BrandonVP/SwitchWarden/teensy40_480x320_lcd.pdf

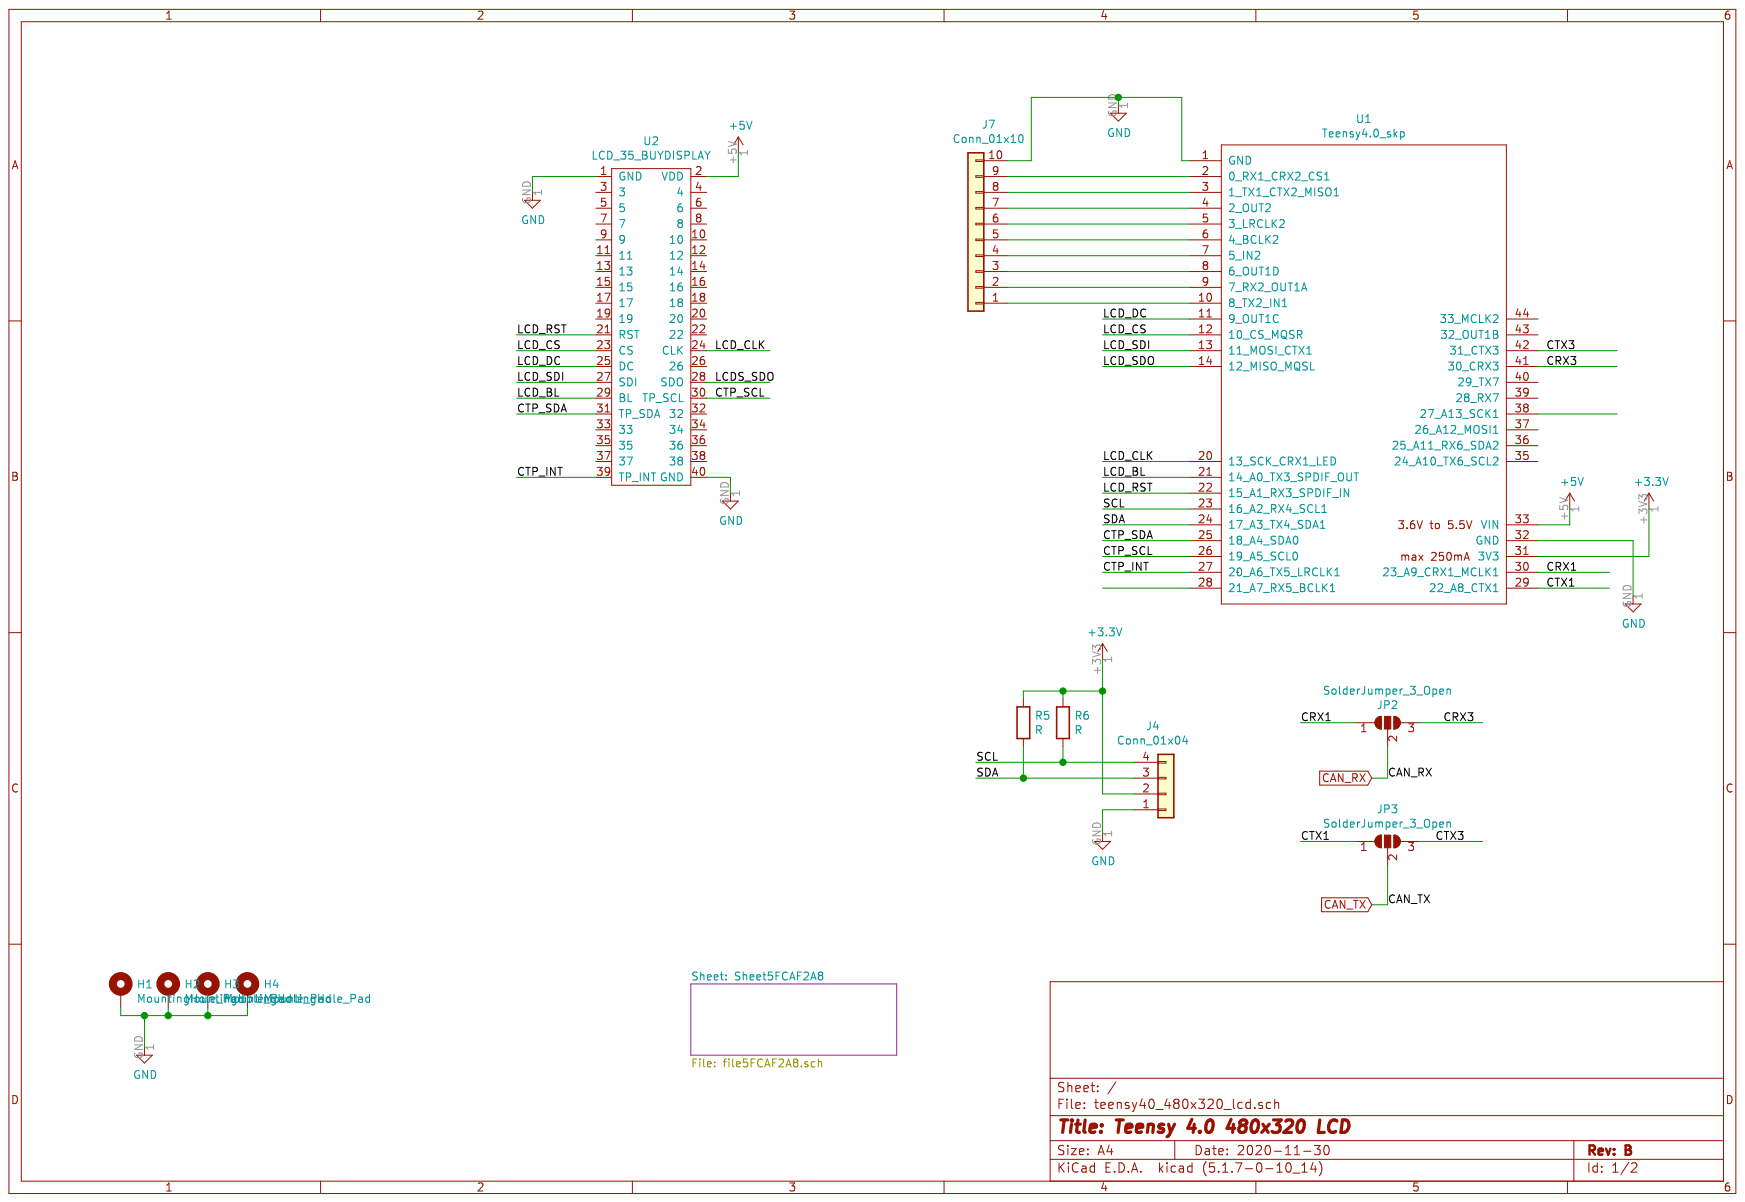
[picture p1: page 1]

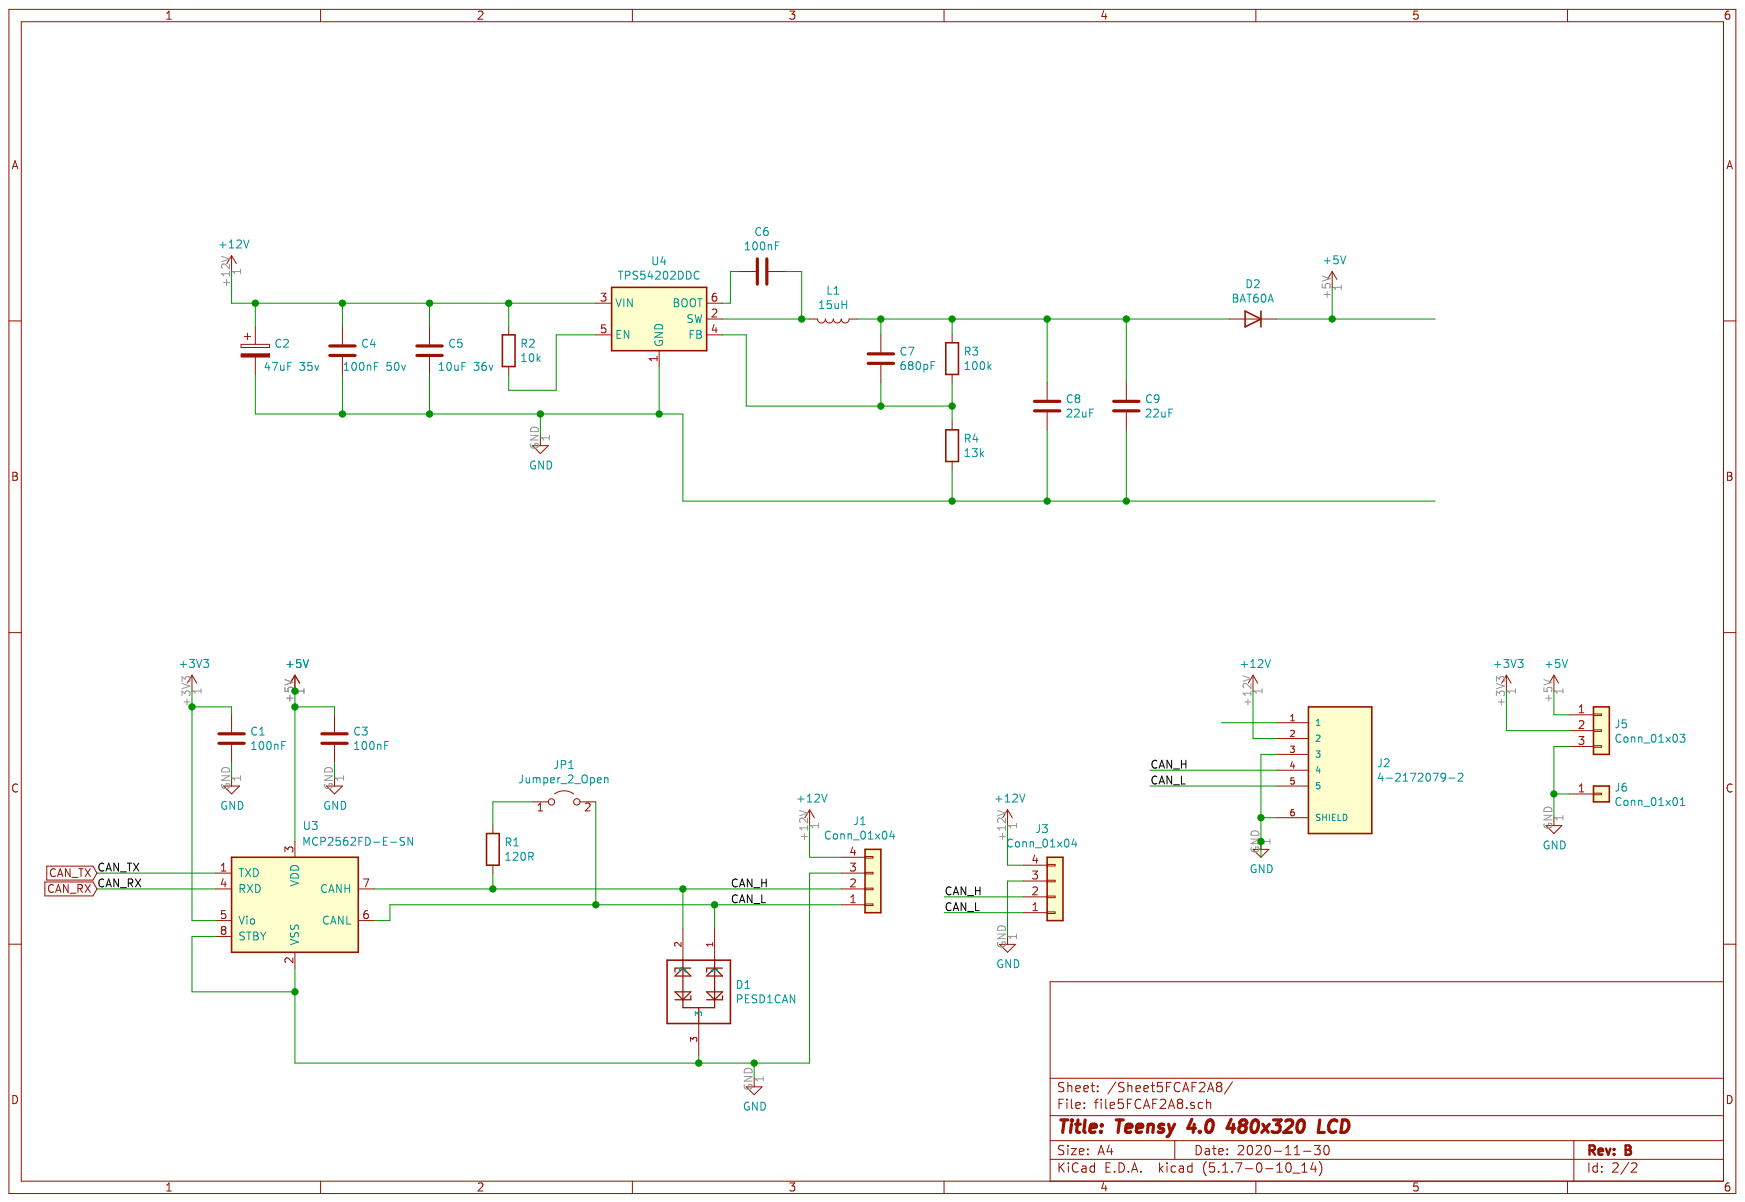
[picture p2: page 2]
