BrandonVP/SwitchWarden/SwitchWarden/PowerApp.cpp

/*
===========================================================================
Name        : PowerApp.cpp
Author      : Brandon Van Pelt
Description : Power tab UI (see PowerApp.h). Three buttons per PSU row: a name
              label, a live run-status pill, and a start/stop action button.
===========================================================================
*/
#include "PowerApp.h"
#include "PowerControl.h"

// Three buttons per PSU row.
static uint8_t nameIdx(uint8_t p)   { return (uint8_t)(3 * p + 0); }
static uint8_t statusIdx(uint8_t p) { return (uint8_t)(3 * p + 1); }
static uint8_t actionIdx(uint8_t p) { return (uint8_t)(3 * p + 2); }

// Action button click-return values (1..PSU_COUNT; -1 means "no tap").
static const int ACTION_BASE = 1;

// Fixed accent colors (RGB565) that read the same across themes.
static const uint16_t COL_RUN   = 0x07E0; // green — running
static const uint16_t COL_LOCK  = 0x8410; // grey  — cooling locked on
static const uint16_t COL_DIM   = 0x8410; // grey  — "OFF" / disabled text
static const uint16_t COL_FAULT = 0xF800; // red   — cooling-loss safety fault

static const char* const PSU_NAMES[PSU_COUNT] = { "Brandon", "Jason", "Ubuntu", "Cooling" };

static bool s_lastRunning[PSU_COUNT];
static bool s_lastCommanded[PSU_COUNT];

static void styleStatus(uint8_t p)
{
    UserInterfaceClass& s = GUI_I.appButtons()[statusIdx(p)];

    // Cooling-loss fault takes over the cooling row's pill.
    if (p == PSU_COOLING && POWER_isCoolingFault())
    {
        s.setText("FAULT");
        s.setBgColor(COL_FAULT);
        s.setBorderColor(COL_FAULT);
        s.setTextColor(0xFFFF);
        return;
    }

    bool run = POWER_isRunning(p);
    s.setText(run ? "RUNNING" : "OFF");
    s.setBgColor(run ? COL_RUN : gfxTheme.background);
    s.setBorderColor(run ? COL_RUN : gfxTheme.btnBorder);
    s.setTextColor(run ? 0x0000 : COL_DIM);
}

static void styleAction(uint8_t p)
{
    UserInterfaceClass& a = GUI_I.appButtons()[actionIdx(p)];

    // While a cooling fault is latched, the cooling action becomes "ACK".
    if (p == PSU_COOLING && POWER_isCoolingFault())
    {
        a.setText("ACK");
        a.setBgColor(COL_FAULT);
        a.setBorderColor(COL_FAULT);
        a.setTextColor(0xFFFF);
        a.setClickable(true);
        return;
    }

    bool on = POWER_isCommanded(p);
    bool locked = (p == PSU_COOLING) && POWER_isCoolingLocked();

    if (locked)
    {
        a.setText("LOCKED");
        a.setBgColor(gfxTheme.orangeBtn);
        a.setBorderColor(COL_LOCK);
        a.setTextColor(0x0000);
        a.setClickable(false);
    }
    else
    {
        a.setText(on ? "STOP" : "START");
        a.setBgColor(on ? gfxTheme.orangeBtn : gfxTheme.btnColor);
        a.setBorderColor(gfxTheme.btnBorder);
        a.setTextColor(on ? 0x0000 : gfxTheme.btnText);
        a.setClickable(true);
    }
}

uint8_t power_createBtns(void)
{
    UserInterfaceClass* b = GUI_I.appButtons();

    // Airy backdrop: a light-blue -> white gradient behind the cards.
    GUI_I.fillGradientV(0, GFX_MENU_BAR_HEIGHT, GFX_SCREEN_WIDTH, GFX_SCREEN_HEIGHT - GFX_MENU_BAR_HEIGHT,
                        gfxShade(gfxTheme.menuBg, 85), 0xFFFF);

    uint16_t cardShadow = 0xBDD7;   // soft grey drop shadow (tune on hardware)

    for (uint8_t p = 0; p < PSU_COUNT; p++)
    {
        int y = 58 + p * 63;

        // Floating white card for this PSU.
        GUI_I.drawCard(10, y, 460, 54, 12, 0xFFFF, cardShadow, 3);

        // Name — navy text on the card (fill = card white, so no visible box).
        b[nameIdx(p)].setButton(20, y, 156, y + 54, 0, true, 8, PSU_NAMES[p], ALIGN_LEFT,
                                0xFFFF, 0xFFFF, gfxTheme.btnTextColor);
        b[nameIdx(p)].setClickable(false);
        b[nameIdx(p)].setTextSize(16);

        // Run-status pill (non-clickable) — styled from the monitor input.
        b[statusIdx(p)].setButton(160, y + 8, 298, y + 46, 0, true, 12, "OFF", ALIGN_CENTER,
                                  0xFFFF, gfxTheme.btnBorder, COL_DIM);
        b[statusIdx(p)].setClickable(false);
        b[statusIdx(p)].setTextSize(13);

        // Start/stop action button.
        b[actionIdx(p)].setButton(306, y + 8, 458, y + 46, ACTION_BASE + p, true, 12, "START", ALIGN_CENTER,
                                  gfxTheme.btnColor, gfxTheme.btnBorder, gfxTheme.btnText);
        b[actionIdx(p)].setTextSize(16);

        styleStatus(p);
        styleAction(p);
        s_lastRunning[p]   = POWER_isRunning(p);
        s_lastCommanded[p] = POWER_isCommanded(p);
    }

    return (uint8_t)(PSU_COUNT * 3);
}

// Redraw one PSU's status + action buttons to the panel.
static void refreshRow(uint8_t p)
{
    styleStatus(p);
    styleAction(p);
    GUI_I.updateButton(statusIdx(p));
    GUI_I.updateButton(actionIdx(p));
}

void power_handler(int userInput)
{
    // A tap on an action button toggles that PSU. Because starting/stopping a PC
    // can lock or unlock the cooling supply, redraw every row.
    if (userInput >= ACTION_BASE && userInput < ACTION_BASE + PSU_COUNT)
    {
        uint8_t tapped = (uint8_t)(userInput - ACTION_BASE);

        // A tap on the cooling row while a fault is latched acknowledges it;
        // otherwise it toggles the supply.
        if (tapped == PSU_COOLING && POWER_isCoolingFault())
            POWER_ackCoolingFault();
        else
            POWER_toggle(tapped);

        for (uint8_t p = 0; p < PSU_COUNT; p++)
        {
            refreshRow(p);
            s_lastRunning[p]   = POWER_isRunning(p);
            s_lastCommanded[p] = POWER_isCommanded(p);
        }
        GUI_I.updateScreen();
        return;
    }

    bool dirty = false;

    // Run-status pills follow the monitor inputs.
    for (uint8_t p = 0; p < PSU_COUNT; p++)
    {
        bool run = POWER_isRunning(p);
        if (run != s_lastRunning[p])
        {
            s_lastRunning[p] = run;
            styleStatus(p);
            GUI_I.updateButton(statusIdx(p));
            dirty = true;
        }
    }

    // Commanded state can change with no tap — the cooling auto-on/auto-off
    // logic. If any changed, restyle all action buttons since the cooling lock
    // depends on whether a PC is running.
    bool cmdChanged = false;
    for (uint8_t p = 0; p < PSU_COUNT; p++)
    {
        bool cmd = POWER_isCommanded(p);
        if (cmd != s_lastCommanded[p])
        {
            s_lastCommanded[p] = cmd;
            cmdChanged = true;
        }
    }
    if (cmdChanged)
    {
        for (uint8_t p = 0; p < PSU_COUNT; p++)
        {
            styleAction(p);
            GUI_I.updateButton(actionIdx(p));
        }
        dirty = true;
    }

    // Latched cooling fault (set by the interlock in POWER_tick, cleared by ACK):
    // repaint the cooling row's pill + action to show/hide the alert.
    static bool s_lastFault = false;
    bool fault = POWER_isCoolingFault();
    if (fault != s_lastFault)
    {
        s_lastFault = fault;
        refreshRow(PSU_COOLING);
        dirty = true;
    }

    if (dirty)
        GUI_I.updateScreen();
}
