BrandonVP/SwitchWarden/SwitchWarden/Version.h

/*
===========================================================================
Name        : Version.h
Author      : Brandon Van Pelt
Description : Single source of truth for the SwitchWarden firmware version.
              Bump SWITCHWARDEN_VERSION on each release; it shows on the
              Settings > About page.
===========================================================================
*/
#ifndef VERSION_H
#define VERSION_H

#define SWITCHWARDEN_VERSION "1.0.0"

#endif // VERSION_H
