BrandonVP/SwitchWarden/SwitchWarden/MonitorApp.h

/*
===========================================================================
Name        : MonitorApp.h
Author      : Brandon Van Pelt
Description : Monitor tab — placeholder page for now.
===========================================================================
*/
#ifndef MONITORAPP_H
#define MONITORAPP_H

#include "appConfig.h"

uint8_t monitor_createBtns(void);
void    monitor_handler(int userInput);

#endif // MONITORAPP_H
