BrandonVP/SwitchWarden/(commit log)

2026-08-12 Initial commit: SwitchWarden power controller front end
    Teensy 4.0 + 480x320 ILI9488/FT6206 panel managing power to 3 water-cooled
    PCs plus the shared cooling PSU, built on the EmbeddedGFX library.
    - Power/Monitor/Settings tabs (Power + Monitor open directly, Settings is a
    menu-landing so more settings apps can be added).
    - PowerControl: 4 start outputs + 4 run-status inputs on J7 (Teensy pins 0-8),
    cooling force-locked while any PC runs, auto-off 10s after the last PC stops.
    - ILI9488/FT6206 adapters, no battery icon, clock kept in the status bar.
2026-08-12 Consume EmbeddedGFX as a git submodule
    Add EmbeddedGFX at SwitchWarden/Libraries/EmbeddedGFX (pinned to the Snow
    commit) and point the .sln/.vcxproj shared import at it. Visual Micro compiles
    the library from the project-local Libraries folder, so the repo is now
    self-contained (clone with --recurse-submodules).
2026-08-14 Restyle to a light frost look (gradients + floating cards)
    Bump EmbeddedGFX submodule to 5f45da5 (graphics helpers) and apply the
    reference smart-panel aesthetic:
    - Light frost palette (white body, blue header, navy text, orange stop accent).
    - Gradient menu bar with text-only tabs drawn over the gradient (kept the tab
    layout); removed the status-bar clock for a clean header.
    - Power tab: light-blue -> white body gradient with each PSU on a floating
    white card (drawCard drop shadow); Monitor tab matches the backdrop.
2026-08-14 Frost tab polish: larger tab font, menuText color, Snow frost bar
    Bump EmbeddedGFX submodule to 065faa0 (mutually-exclusive touch-region
    flags fix new + GfxTheme.menuText). drawMenuBar uses Michroma_16 (was 14)
    so tab text renders fuller, and draws tab labels in gfxTheme.menuText so
    selecting Settings > Themes > Snow shows the frost bar. applyFrostPalette
    sets menuText = white.
    [SwitchWarden.ino]
